h-tu/autonomous-OSV/README.md

# Autonomous Over-Sand Vehicle

Hongyu Tu

------
### Disclaimer: 
This project is inspired by UMD ENES100 course and was build off of the base that was done on both software and hardware side by the ENES100 faculties. For more information you are welcomed to visit their website. I do no own any of the ENES100 library.

You can find all the information that you will need about ENES100 library here: [documentation](https://github.com/h-tu/autonomous-OSV/blob/master/Using%20the%20Arduino%20Library.pdf)

This library is required for the code in this project to function properly.

**No reuse of this project for academic and competition purposes in any form. All rights reserved.**

------
### Documentation: 

For all the information throughout the whole building process in the final report, click here: 
[Final report](https://github.com/h-tu/autonomous-OSV/blob/master/final%20report.pdf)

For the detailed control decision tree and animation, go to here: 
[Animation](https://github.com/h-tu/autonomous-OSV/blob/master/full%20animation.pptx)

The full code is called debris.ino, you can find it in this repo.

------

### Main objective
* Navigate to within 250 mm of the aircraft debris (mission site)
* Measure and transmit the type of material present
* Transmitted material type is correct

### Advanced Requirements:
* Acquire the debris by lifting it entirely off of the sand
* Determine the mass of the debris to within 20 g and transmit the result       

------
### Vehicle setup: 

<p align="center">
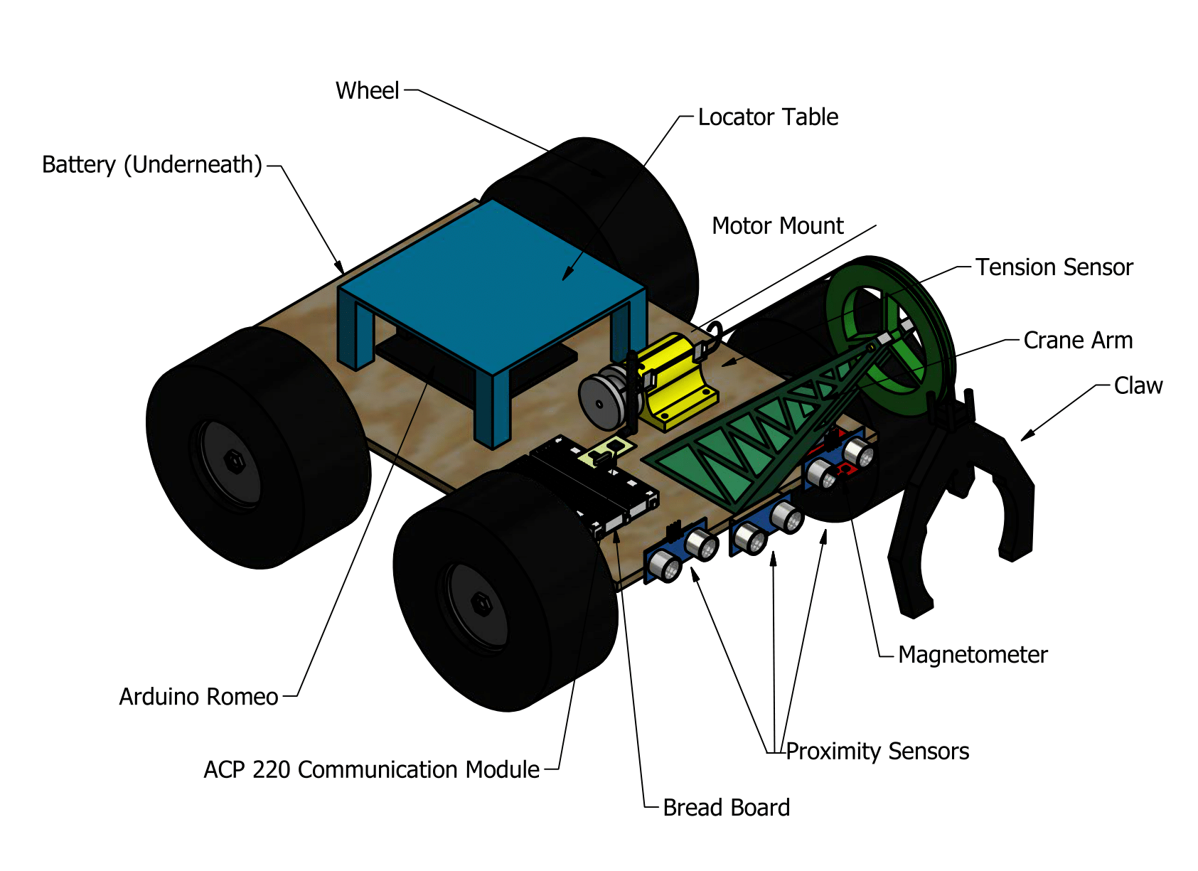
[picture p1: cad1.png]
  
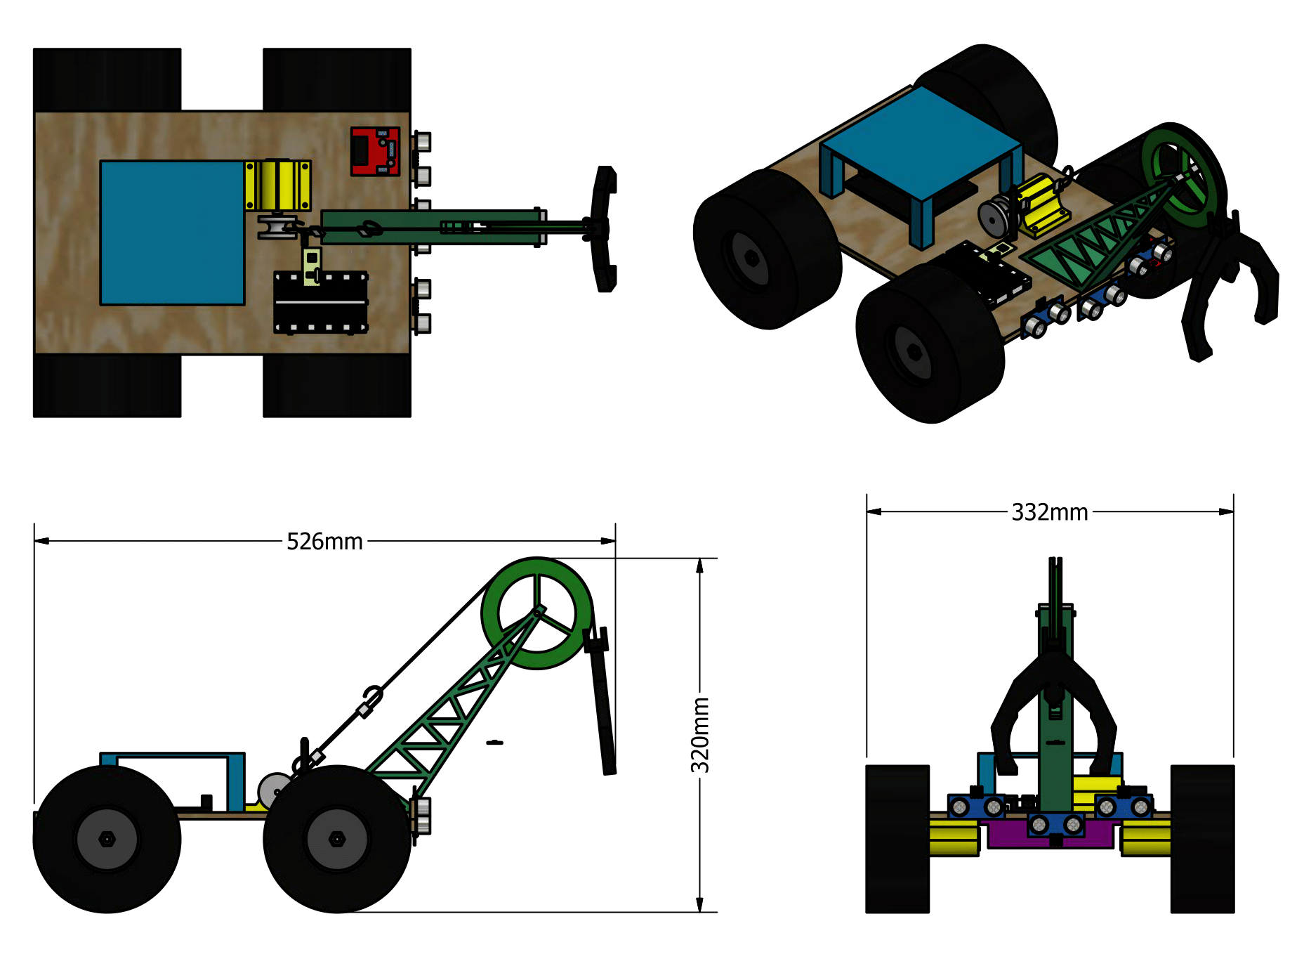
[picture p2: cad2.png]
  
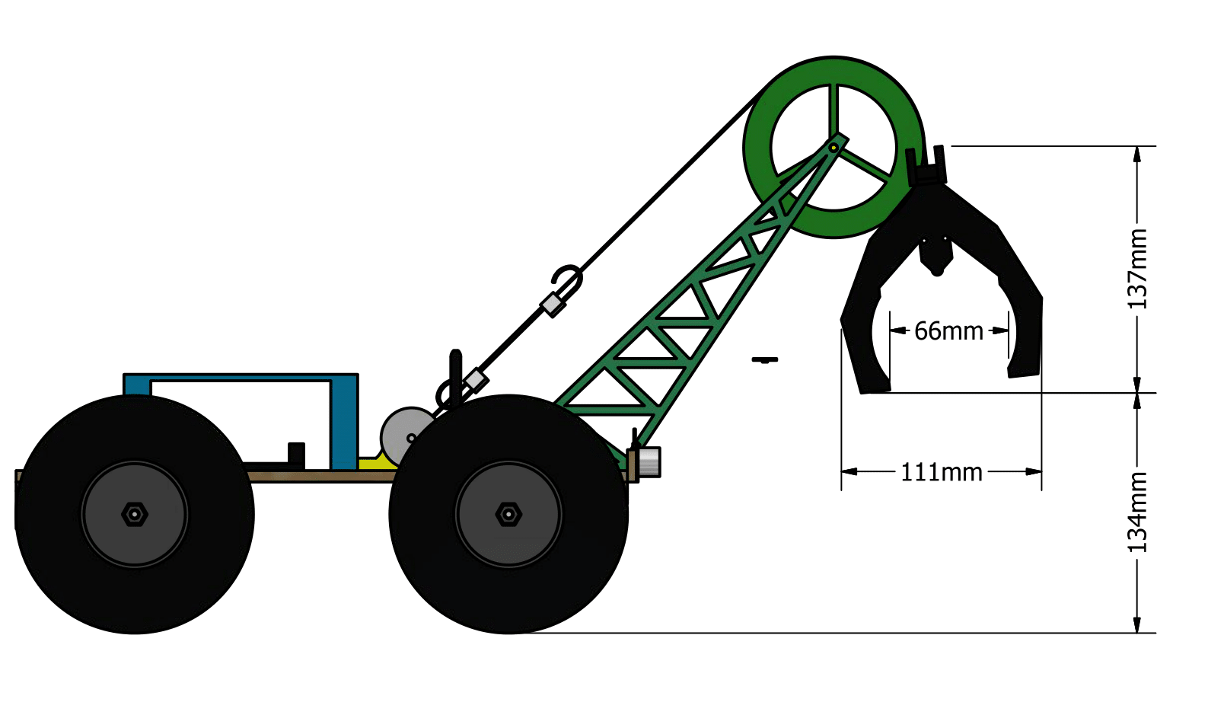
[picture p3: cad3.png]
  
</p>

------
### Flowchart: 

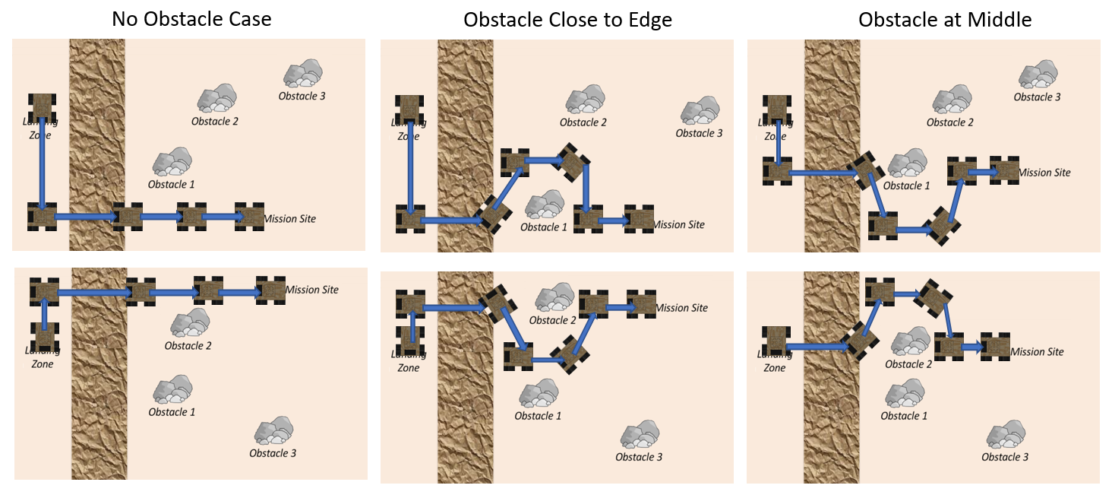
[picture p4: flow chart.png]


------
### Demonstration
https://github.com/h-tu/autonomous-OSV/blob/master/IMG_3600.MOV

Go terps! :turtle::turtle::turtle:
